CorshamTech/Music_Board/(threads)

Thread 1 (2021-12-27):

swapped pins

btb, 2021-12-27:
I have one of the original boards (Newtech Model 68 rev. B) and I was curious about the out-of-order bits issue speculated about on Robin Grosset's video - https://youtu.be/TBFA2xbCjZ4. I took a close look at my original board and the bits are definitely not out of order. The circuit does look identical to this eagle project, except that pins 2 and 7 of the 74LS174 are backwards. I am guessing that this was done inadvertently between your initial run and the cleanup for posting on github. If you would like photos of the board I can provide some.

CorshamTech, 2021-12-28:
Hi,

So swapping those two pins will make it the same as the original board?  That’s easy enough to do, and I can fix one other problem in that the silkscreen does not show component values.

Bob

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

CorshamTech, 2021-12-28:
Do you have an original schematic?  I am not sure where I picked up the schematic when doing my board but now I can’t find it on-line.  Swapping pins 2 and 7 seems wrong as 2 is an input while 7 is an output.

Bob

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

btb, 2021-12-28:
That should do it I'm pretty sure, yes.
I don't have the schematic or any original documentation unfortunately, other than parts of the info found here that apply to the model 68: https://deramp.com/downloads/mfe_archive/010-S100%20Computers%20and%20Boards/01-Newtech/

I'd really love to find some of the original demo software if you happen to have that

CorshamTech, 2021-12-28:
Here is a link I found this morning:

https://deramp.com/downloads/mfe_archive/010-S100%20Computers%20and%20Boards/01-Newtech/80-Newtech%20Newsletters/NewTechniqueNewsLetter_2.pdf <https://deramp.com/downloads/mfe_archive/010-S100%20Computers%20and%20Boards/01-Newtech/80-Newtech%20Newsletters/NewTechniqueNewsLetter_2.pdf>

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
